JEGP20/Portable-Electrocardiograph/Portable Test.pdf

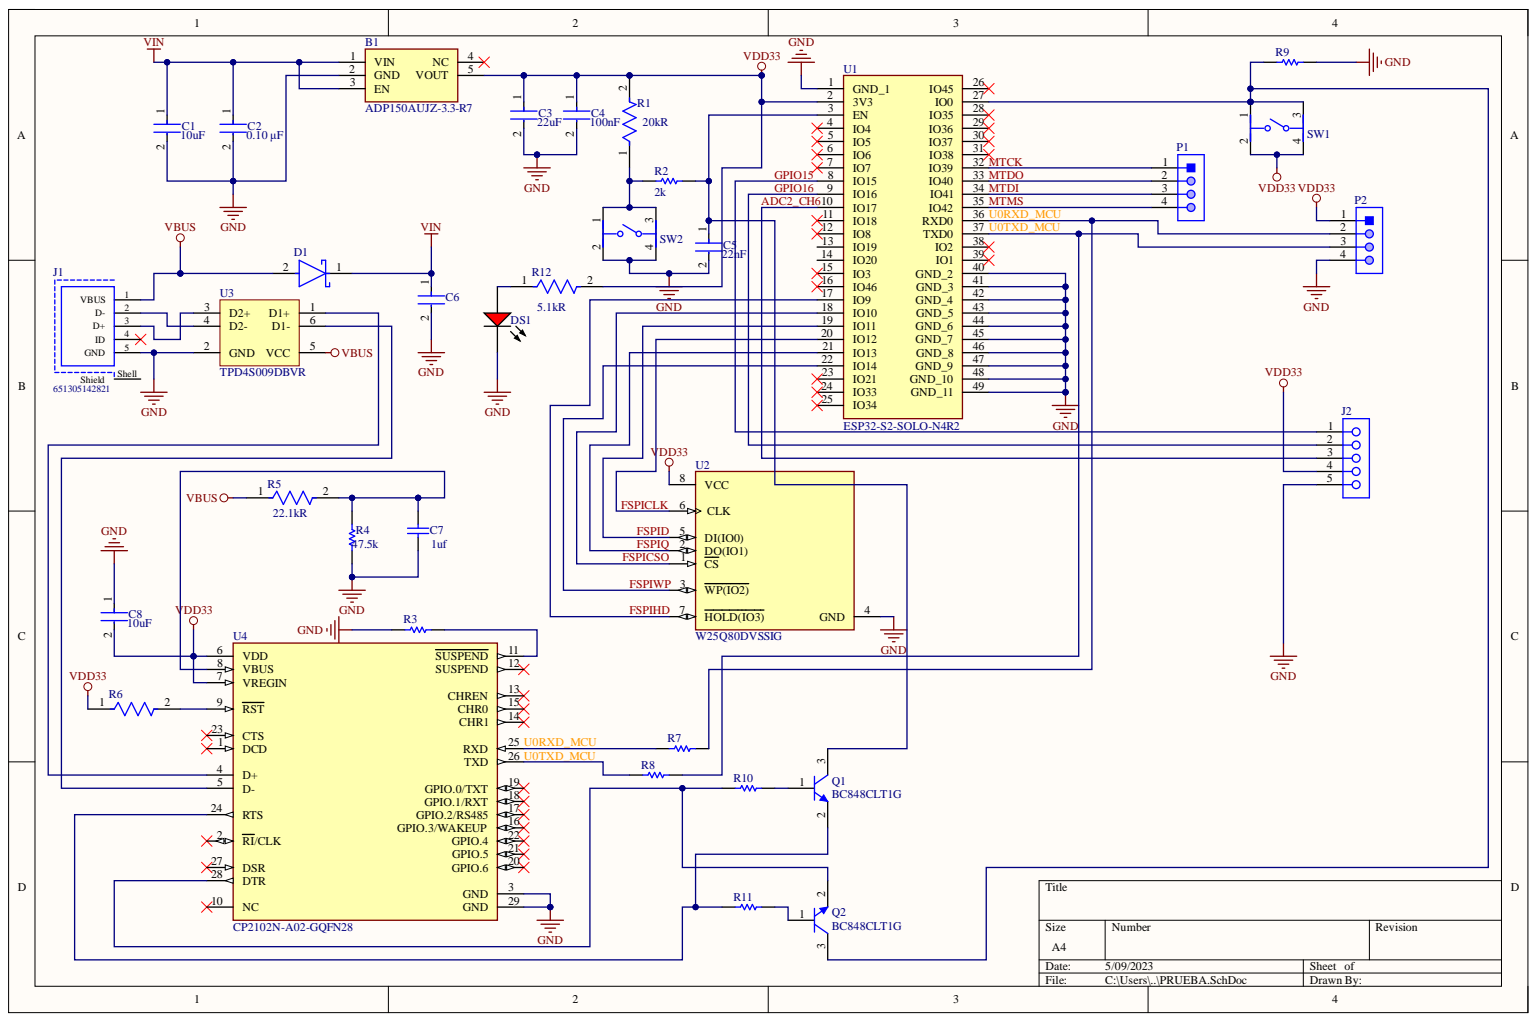
[picture p40: page 1]

GPIO16 | | IO16 9 IO41 | 34 MTDI 3 | VDD33
ADC2_CH6 | | IO17 10 IO42 | 35 MTMS 4

IO18 11
IO8 12 | U0TXD_MCU | 2

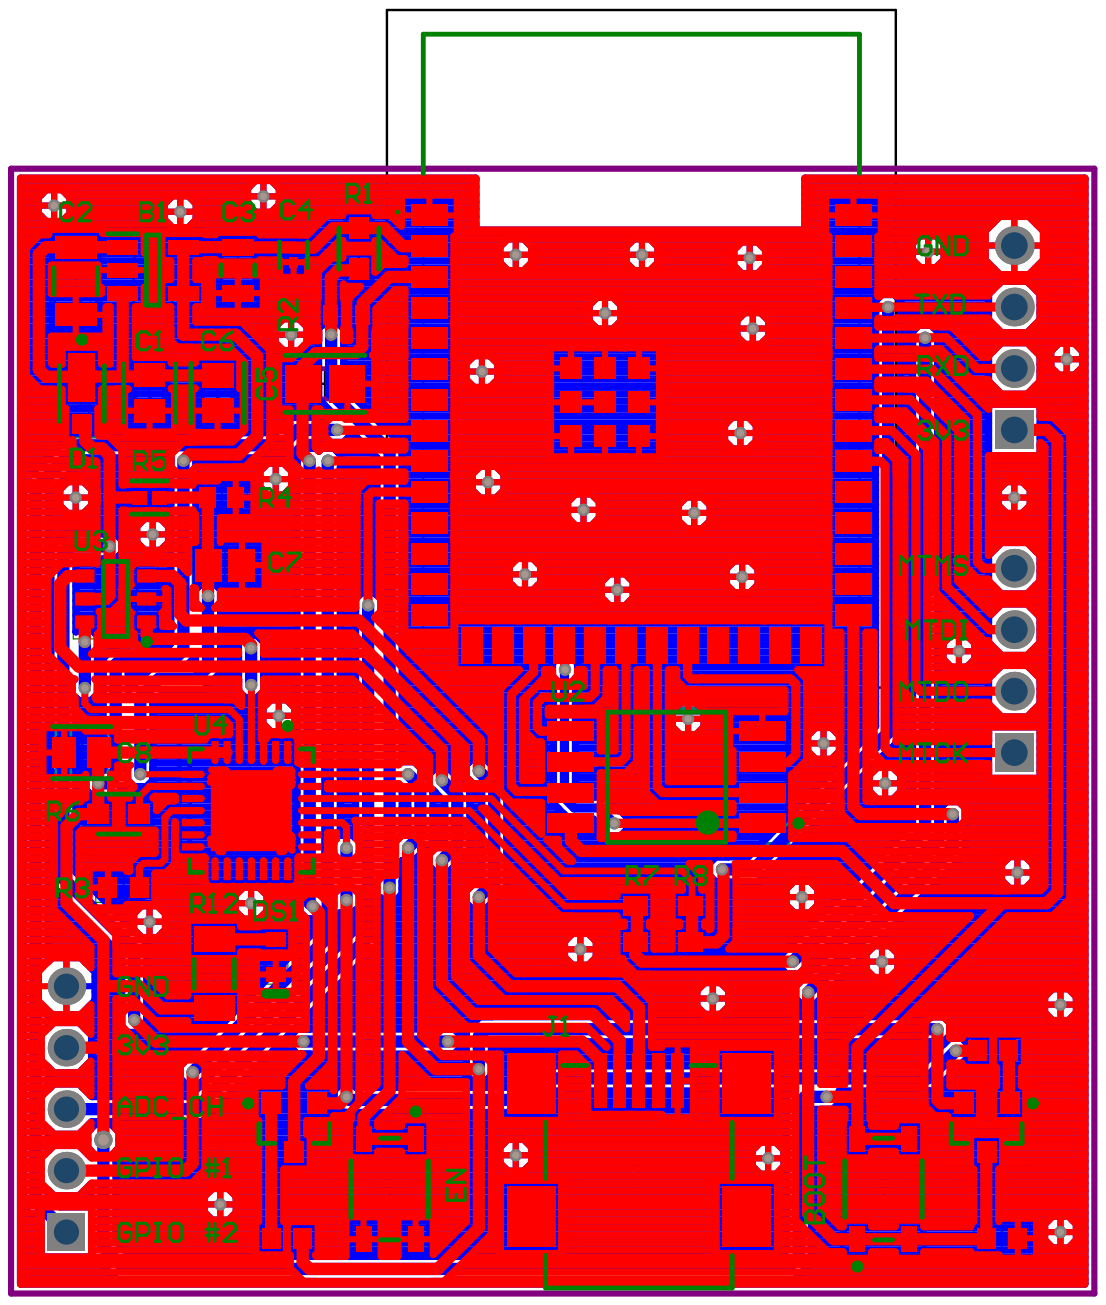
[picture p41: page 2]

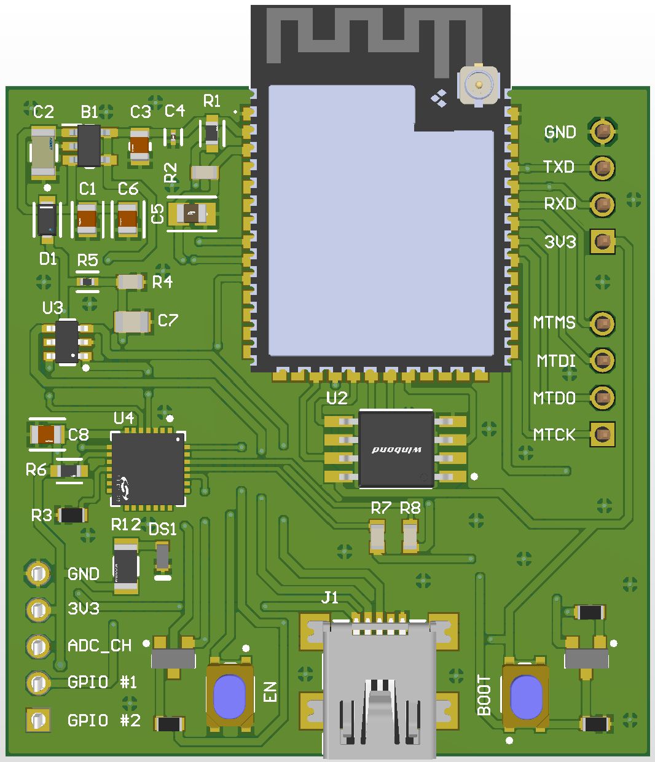
[picture p42: page 3]

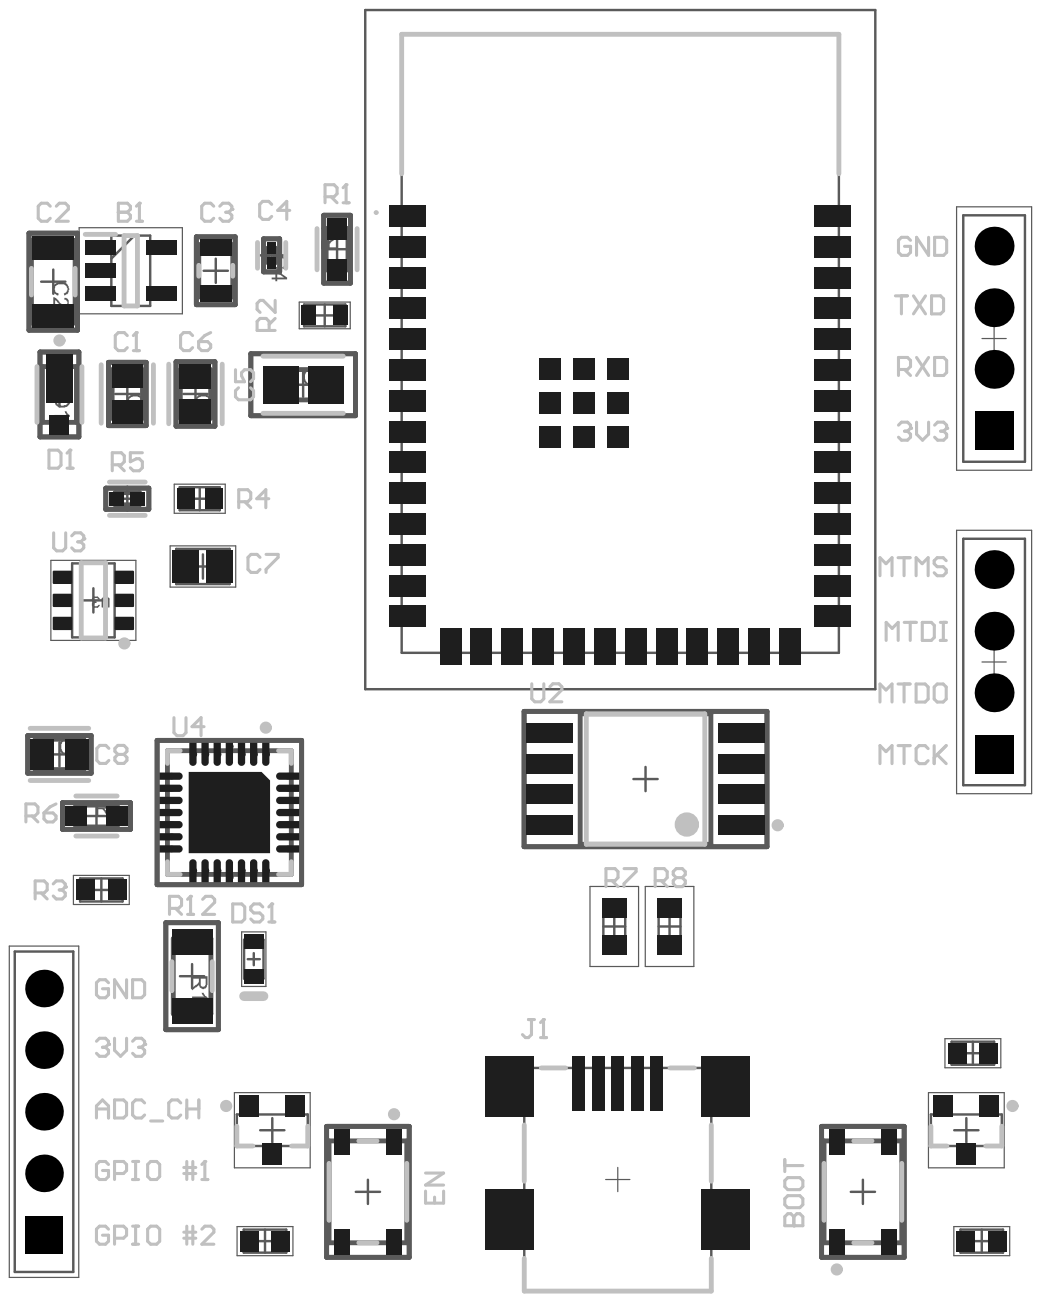
[picture p43: page 5]

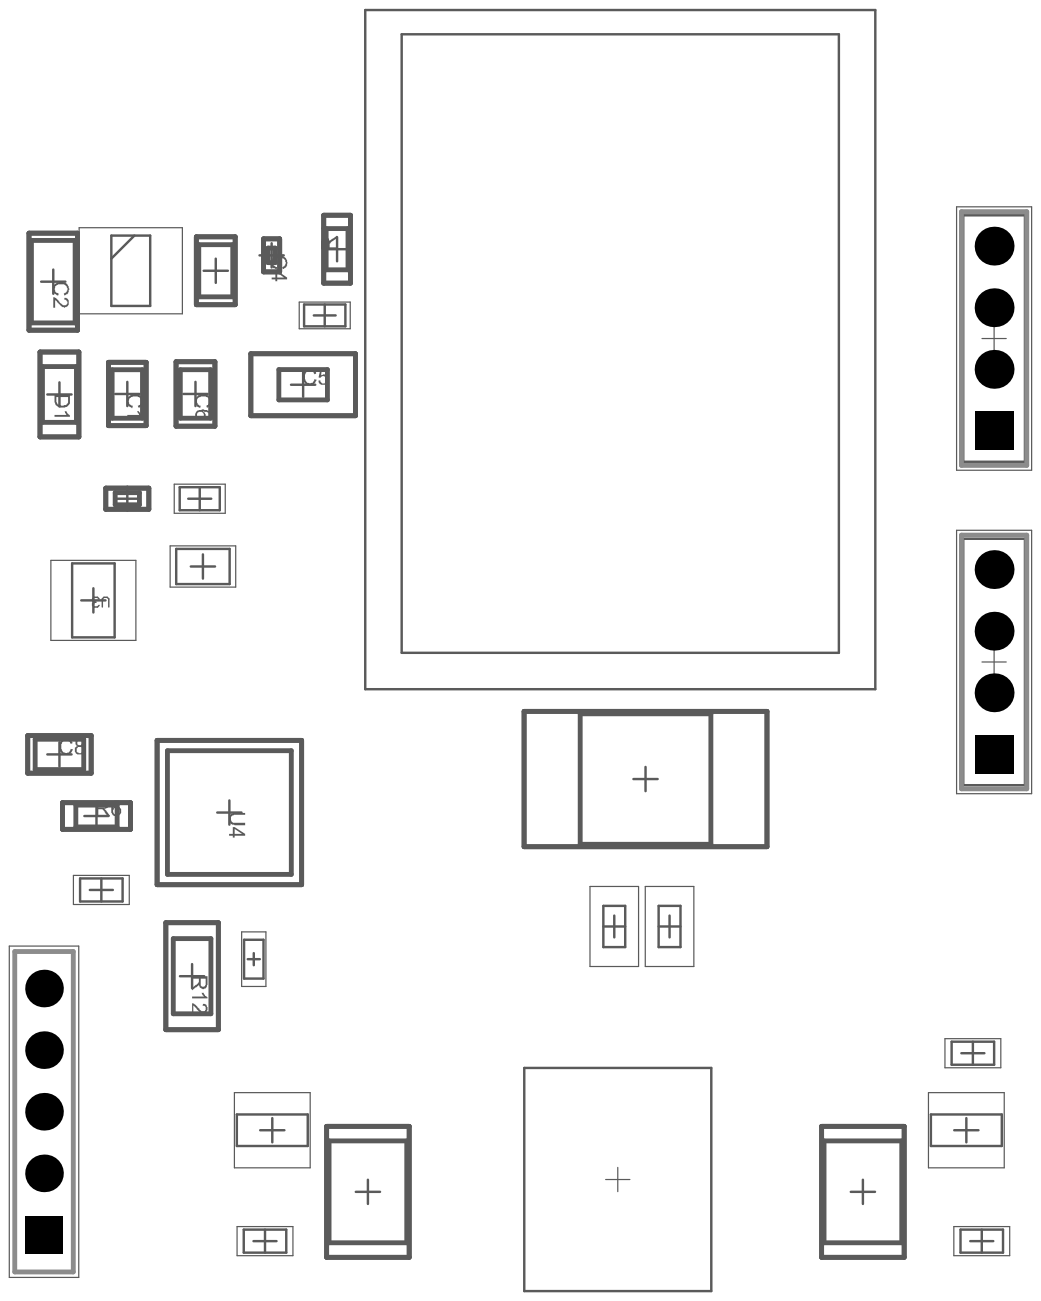
[picture p44: page 6]

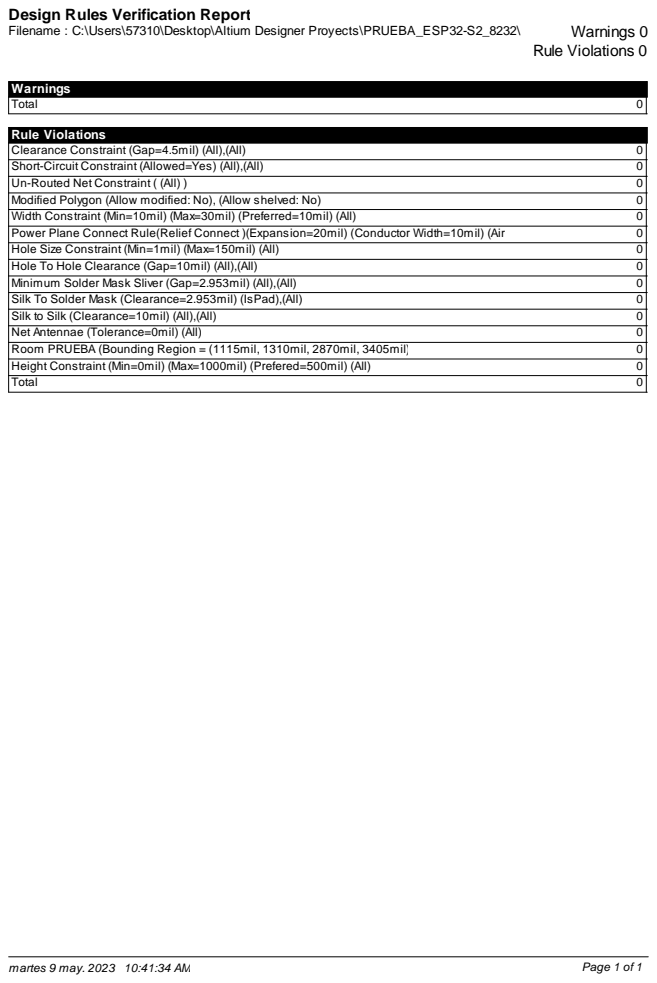
[picture p45: page 7]

Design Rules Verification Report
