JEGP20/Portable-Electrocardiograph/(list of files, drawings)

Other design files:
Portable Test Electrocardiograph/Portable Test Electrocardiograph.PrjPcb
Portable Test Electrocardiograph/Test.PcbDoc
Portable Test Electrocardiograph/Test.SchDoc
